herny197/FAN_f103c8t6_v2/README.md

# FAN_f103c8t6_v1 风扇控制工程

STM32F103C8T6（LQFP48），HAL + CMSIS-RTOS2 / FreeRTOS，Keil ARMCC 5。硬件参考“风扇2”；当前PADS接线中的LED7/R76对应程序的第五路LED，即PB1。

## 当前实现的功能

- 默认任务在业务循环之前调用一次 `user_Init()`，读取内部Flash恢复目标转速，初始化业务并放行其他任务。上电自动运行；没有有效记录时默认600 RPM，不立即写入默认值。
- 编码器顺时针升速，逆时针降速，每格100 RPM，目标范围0～1500 RPM。TIM2硬件完成A/B正交计数，任务读取计数差。方向按用户报告的板上结果反转，每格计数仍为调试值。
- 按键稳定30ms后切换启停，一次按压只触发一次。停止立即灭灯并锁定旋钮，目标保留；再次按下恢复原目标。停止期间仍消费计数并清半格，消息代次防止暂停旋转在恢复后重放。
- 运行中把旋钮调到0档时进入减速切换。每步等待新测速确认下降，进入100 RPM附近（50～150 RPM）后结束切换并请求风扇端0% PWM。继续顺时针转动可取消减速或从0档重新启动。
- LED按目标值从LED5、LED4、LED3、LED2到LED1累计点亮，低电平有效。0～299不亮，300～599只亮LED5，600～899亮两灯，900～1199亮三灯，1200～1499亮四灯，1500五灯全亮。按键停机或保护停机立即灭灯。
- TIM3下降沿输入捕获测量TACH。中断只记录周期及序号，RPM在任务中换算；首个边沿、过捕获、无脉冲超时及跨Flash擦写样本不作为有效反馈。
- 正常调速使用新有效反馈，PWM最短调整间隔为100ms，每步最多2个百分点，闭环死区为±30 RPM。软启动每步最短200ms，从0%小步升速。启动最长12秒无有效测速时请求0%，待再次按键启动。
- 切换时以最新有效实测为起点，每个中间档最多推进100 RPM。达到相邻档中点即可推进，例如400→600先追踪500，实测到450时推进600。降速按反方向判定。中间档满5秒未过中点就触发 `FAN_FAULT_STAGE_TIMEOUT` 保护。
- 启动或换档后，内部追踪最终目标且有效反馈进入最终目标±50 RPM时转入稳定状态。600 RPM档的稳定入口为550～650 RPM。只在稳定状态监测转速超差，允许范围取±100 RPM与±10%中较宽的一项。新有效反馈确认连续越界满1秒就触发 `FAN_FAULT_SPEED_DEVIATION` 保护。重新进允许范围或收到无效样本时清除超差计时。
- 中间档超时和稳定超差触发保护时，运行目标归零，直接请求风扇端0% PWM，LED全灭。顺时针转一格即可从100 RPM重新软启动。
- 按键停机和旋钮0档共用减速门控。先降一步，至少等待200ms，调整后完整新周期显示转速下降至少10 RPM才继续下一步。每步等待满1秒仍无法继续减速或确认达到低速区时，直接请求风扇端0%并记录异常。按键减速中再次按下可从当前输出恢复原目标。
- 有效旋转重置静止计时。静止满3秒且人工选择的目标与已保存值不同时发起一次保存；失败后等到下次有效旋转才可重试。手动选0档可保存，保护归零只改变本次运行目标。
- Flash采用双页追加日志，含版本、序号、目标反码、CRC16及最后写入的提交标志。换页时保留上一有效页，拒绝半写和损坏记录。掉电可能丢失尚未提交的新设定，启动恢复最近有效记录。

## 任务及模块

| CubeMX任务 | 用户入口 | 职责 | 等待 | 原有栈 |
|---|---|---|---|---|
| defaultTask | My_Task1 | user_Init、控制状态、测速消费、唯一运行时PWM输出 | 约10ms | 128 words / 512字节 |
| myTask02 | My_Task2 | 编码器累计计数读取、按键去抖、输入事件生产 | 约5ms | 256 words / 1024字节 |
| myTask03 | My_Task3 | 目标灯条、唯一运行时Flash写入 | 约20ms | 256 words / 1024字节 |

任务数量、优先级、栈和8192字节RTOS堆未改变，不需要为本轮增加CubeMX任务。输入使用静态队列；Task1独占控制状态，通过短临界区快照发布。初始化完成前其他任务阻塞等待；实际Flash擦写不放在全局长临界区内。

- `Core/Src/user_work.c`：任务组织、就绪门控、输入启停代次和保存同步。
- `Core/Src/fan_control.c`：与硬件无关的状态机、LED阈值和一次性保存资格判定。
- `Core/Src/fan_io.c`：硬件编码器、按键、TACH、反相PWM和LED输出。
- `Core/Src/fan_settings.c`：双页设置日志与校验。
- Keil调试可用 `g_fan_status` 查看运行目标 `control.target_rpm`、人工设置 `control.save_target_rpm`、当前追踪档位 `control.control_target_rpm`、实际测速 `measured_rpm`、风扇端占空比 `control.duty_permille` 和故障位 `control.faults`。

## 引脚与调试参数

| 功能 | 当前配置 |
|---|---|
| PWM | PA8 / TIM1_CH1，72MHz、PSC=0、ARR=2879，计算25kHz |
| NPN反相 | 风扇端0%对应MCU持续高、CCR1=2880；风扇端100%对应CCR1=0 |
| 编码器 | PA0/PA1 / TIM2，TI12。默认4计数/机械格，方向系数−1 |
| 按键 | PB0，外部上拉，按下低电平 |
| TACH | PA6 / TIM3_CH1，PSC=7199，每计数0.1ms；暂按每转2脉冲 |
| LED1～5 | PB12、PB13、PB14、PB15、PB1，低电平亮；GPIO生成初值为高、灯灭 |
| HAL / RTOS时基 | HAL使用TIM4，RTOS节拍1000Hz |

停止时保持PWM通道工作。验证0%请求时，在风扇插头第4脚相对第1脚地测量，应持续为低电平。若12V供电正常且第4脚持续为低，叶片仍保持低速旋转，则这只风扇在当前供电条件下收到0%请求仍会运行。TACH每转脉冲数、编码器每格计数、方向和最低稳定转速仍待实测。

## Flash区域与重新生成

正式64KB Flash末尾两个1KB页专用于设置：

- 页0：0x0800F800～0x0800FBFF。
- 页1：0x0800FC00～0x0800FFFF。
- Keil程序区：起点0x08000000，大小0xF800（62KB）。

Keil工程已登记三个新增.c，并缩小IROM与OCR_RVCT4程序区。重新生成后必须复核这两个限制、三个模块登记、user_work登记和既有任务调用；不能让代码覆盖数据页。下载时若执行全片擦除，历史设置也会丢失，此后按无有效记录恢复默认600 RPM。

本轮未改.ioc、生成的外设初始化、任务创建或中断入口。新增HAL_TIM_IC_CaptureCallback只在fan_io.c定义一次。

## 验证边界

2026-11-08 r2版通过临时工程的完整Keil编译和链接，0错误、0警告。HEX校验通过，数据末地址为0x08005D43，设置区从0x0800F800开始。静态调用图给出的Task1、Task2、Task3最大调用深度分别为180、216、284字节。板上栈高水位待测。

控制器主机测试通过，覆盖目标和显示档位、手动0档的低速确认与超时、分段升降速、5秒切换超时、稳定入口、1秒超差停机、旋转重启、静止保存和计时回绕。Flash模块通过528个模拟断电位置及损坏恢复测试。

用户报告上一版调到0档时叶片仍旋转。本次修订待烧录并复测手动0档的减速过程、两类保护后的旋转启动、风扇第4脚电平和实际停转。控制步长、周期、误差带和超时为可调初值。

本版烧录文件为 `MDK-ARM/FAN_f103c8t6_v1/FAN_f103c8t6_v1_20261108_r2.hex`。
