herny197/FAN_f103c8t6_v2/blander模型/fan_v2_bottom.stl

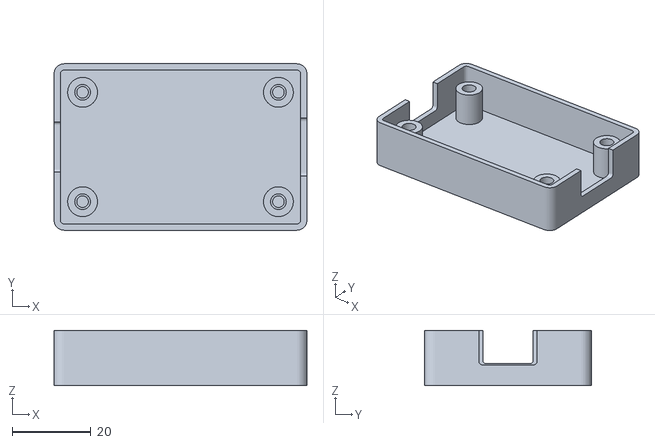
[picture p1: CAD file, 2026-11-08]
blander模型/fan_v2_bottom.stl
64.4 x 42.4 x 14.1
