herny197/FAN_f103c8t6_v2/(list of files, cad)

Other CAD files:
blander模型/fan_control_v1.blend
