herny197/FAN_f103c8t6_v2/Core/Inc/main.h

#define ENC_A_Pin GPIO_PIN_0
#define ENC_A_GPIO_Port GPIOA
#define ENC_B_Pin GPIO_PIN_1
#define ENC_B_GPIO_Port GPIOA
#define FAN_TACH_Pin GPIO_PIN_6
#define FAN_TACH_GPIO_Port GPIOA
#define ENC_SW_Pin GPIO_PIN_0
#define ENC_SW_GPIO_Port GPIOB
#define LED5_Pin GPIO_PIN_1
#define LED5_GPIO_Port GPIOB
#define LED1_Pin GPIO_PIN_12
#define LED1_GPIO_Port GPIOB
#define LED2_Pin GPIO_PIN_13
#define LED2_GPIO_Port GPIOB
#define LED3_Pin GPIO_PIN_14
#define LED3_GPIO_Port GPIOB
#define LED4_Pin GPIO_PIN_15
#define LED4_GPIO_Port GPIOB
#define FAN_PWM_DRV_Pin GPIO_PIN_8
#define FAN_PWM_DRV_GPIO_Port GPIOA
