herny197/FAN_f103c8t6_v2/(commit log)

2026-11-08 v1 这是可运行的第一版。
2026-11-08 最终版本 Final version
    [fan_control_v1.blend, fan_v2.sch, fan_v2_bottom.stl, fan_v2_top.stl]
2026-11-08 补充了两个3d打印的gcode文件。
